nektarios25ma/Solar-tracker/Vertical_Servo_Gear.stl

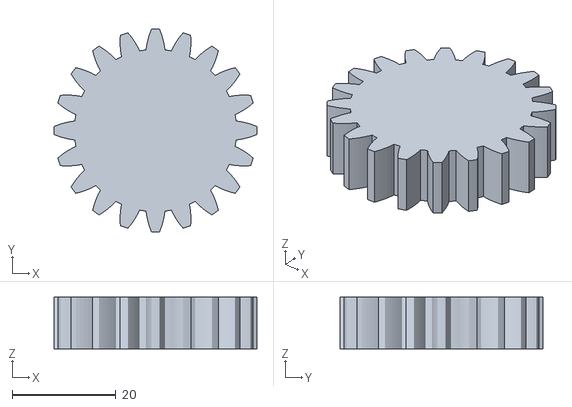
[picture p13: CAD file, 2020-10-01]
Vertical_Servo_Gear.stl
39.2 x 39.2 x 10.0
