nektarios25ma/Solar-tracker/LDR DIVIDER HIGH.stl

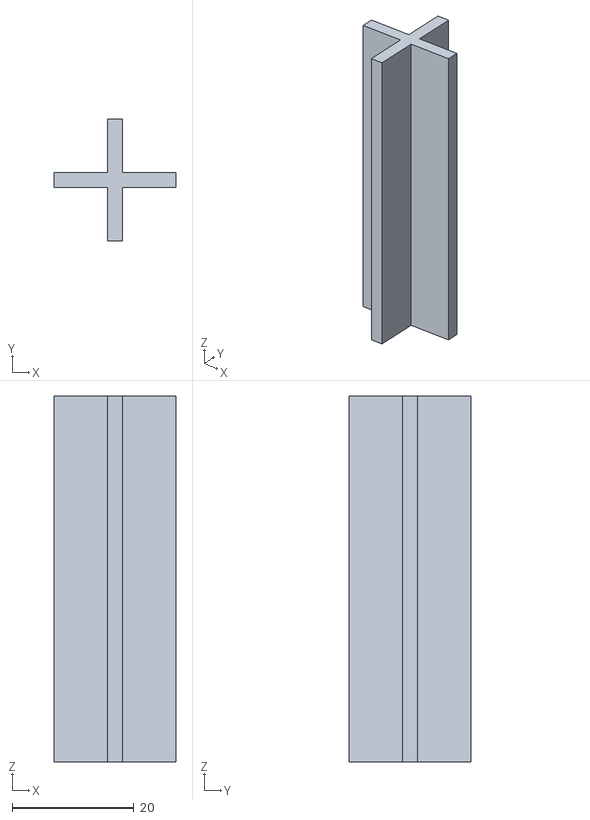
[picture p14: CAD file, 2020-10-01]
LDR DIVIDER HIGH.stl
20.0 x 20.0 x 60.0
