nektarios25ma/Solar-tracker/Panel_Bracket.stl

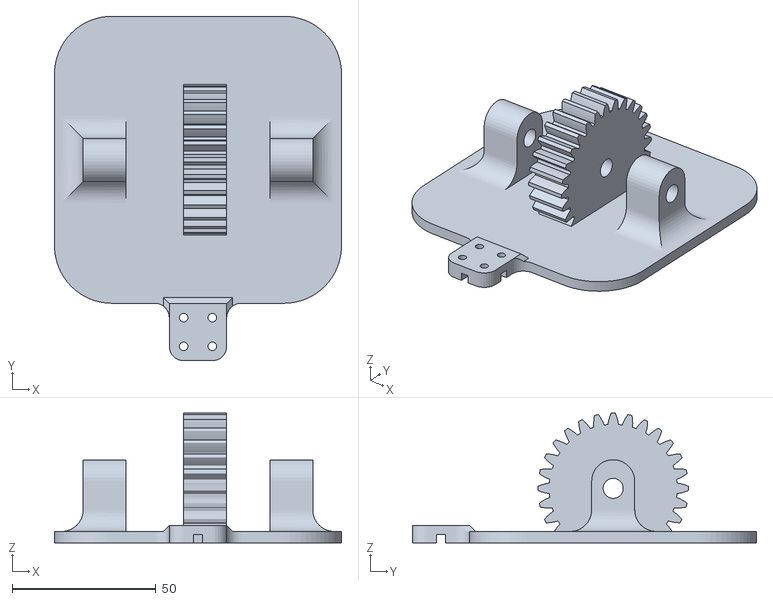
[picture p15: CAD file, 2020-10-01]
Panel_Bracket.stl
100.0 x 120.0 x 45.2
