nektarios25ma/Solar-tracker/Horz_Servo_Gear.stl

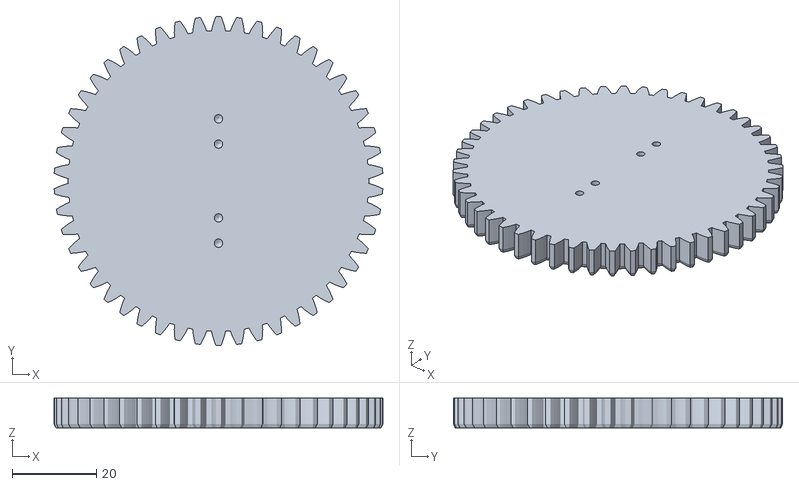
[picture p16: CAD file, 2020-10-01]
Horz_Servo_Gear.stl
77.9 x 78.0 x 7.00
