nektarios25ma/Solar-tracker/Base_Gear_and_Panel_Mount.stl

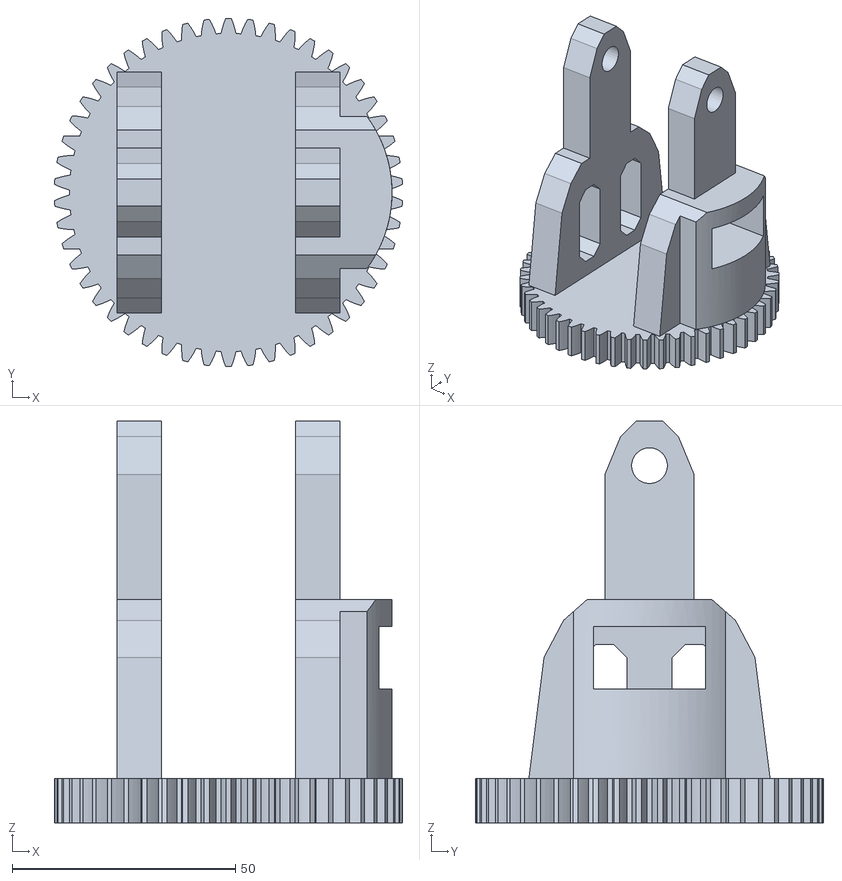
[picture p17: CAD file, 2020-10-01]
Base_Gear_and_Panel_Mount.stl
77.9 x 78.0 x 90.0
