nektarios25ma/Solar-tracker/Tracker_Base.stl

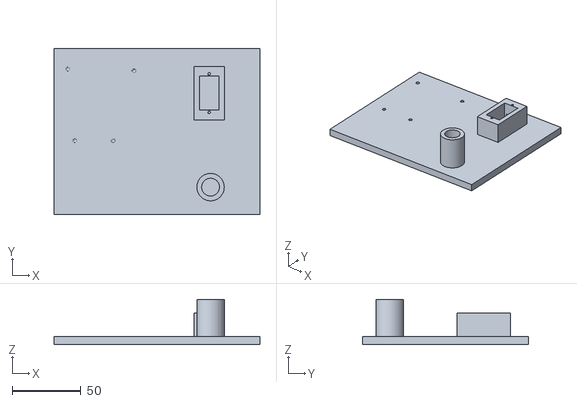
[picture p18: CAD file, 2020-10-01]
Tracker_Base.stl
150.0 x 121.0 x 33.0
