nektarios25ma/Solar-tracker/Base_Gear_Shaft.stl

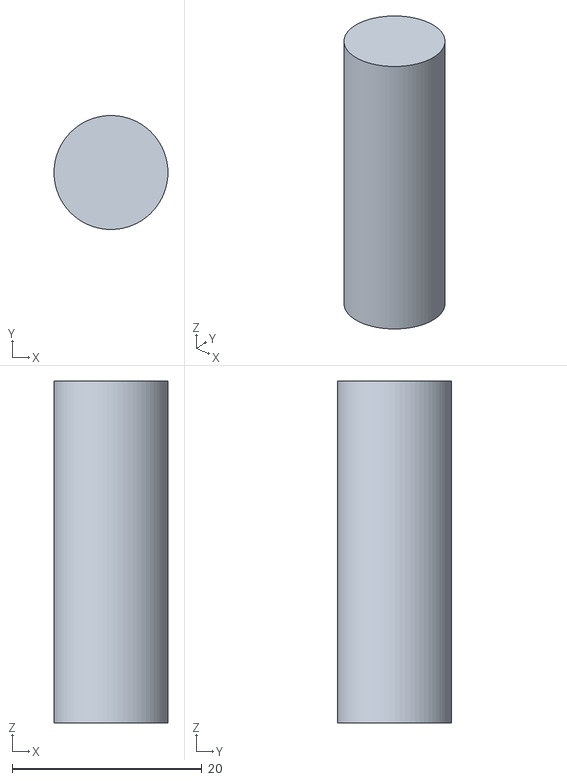
[picture p19: CAD file, 2020-10-01]
Base_Gear_Shaft.stl
12.0 x 12.0 x 36.0
