nektarios25ma/Solar-tracker/construction history.odt

Solar Path Finder

Ιστορικό κατασκεύης

Συντάκτης: Αθηνά Αθανασάκη.

Ξεκινήσαμε κάνοντας εβδομαδιαία μαθήματα ρομποτικής με τον Κ. Κουράκη. Άφου μάθαμε τα βασικά γύρω απο τα κυκλώματα, τον προγραμματισμό και το arduino, προχωρήσαμε σε διάφορες μικρές εργασίες-project για να γίνουμε πιο οικείοι με το arduino.

Μετά από ψάξιμο στο ίντερνετ καταλήξαμε ότι η κατασκευή με την οποία θέλαμε να ασχοληθούμε ήταν ένα solar finder, μιάς και είναι μια συσκευή μέσα στην επικαιρότητα των ημερών αλλά και προσφέρει πολλά περιθώρια για εξέλιξη και πειραματισμό.

Από τις παρακάτω πηγές, πήραμε την αρχική ιδέα για το πως θα έπρεπε να μοιάζει η συσκευή, τη λογική της λειτουργίας της και τον τρόπο προγραμματισμού της.

https://www.instructables.com/id/Arduino-Solar-Tracker/

και τα 3d stl αρχεία από:

https://www.thingiverse.com/thing:53321

(Τα οποία τελικά τα ανασχεδιάσαμε με το online tinkercad)

Έτσι με βάση αυτές, φτιάξαμε μια πρόχειρη κατασκευή χρησιμοποιώντας υλικά απο παιδικά παιχνίδια για να διαπιστώσουμε αν το solar tracker, όντως δούλευε όπως έπρεπε.

Αφού η δοκιμή ολοκληρώθηκε με μερική αποτυχία ,αναγκαστήκαμε να κατανοήσουμε πληρώς το hardware-software και με πολλές διορθώσεις και αλλαγές η 5η δοκιμή μας κατέληξε σε επιτυχία. Ζητήσαμε απο το ΕΚΦΕ Χανίων να μας εκτυπώσει τα 3D κομμάτια που χρειαζόμασταν.

Ξεκινήσαμε γράφοντας ένα απλό πρόγραμμα, ώστε το φωτοβολταϊκό να στρέφεται προς την κατεύθυνση με το περισσότερο φως. Αποφασίσαμε όμως ότι μια ακόμα χρήσιμη εφαρμογή του solar path finder θα ήταν η αποστολή δεδομένων της θέσης του. Με αυτό τον τρόπο μπορούμε να έχουμε καταγραφή των γωνιών που διαγράφει και έτσι, όταν τοποθετείται σε εξωτερικό χώρο, παίρνουμε ξεκάθαρη εικόνα του μονοπατιού του ήλιου σε εκείνη την περιοχή.

Για να το κάνουμε αυτό έπρεπε πρώτα να κατανοήσουμε τον τρόπο με τον οποίο κινείται ο ήλιος και το πως γίνονται αυτές οι μετρήσεις στην πραγματικότητα, ώστε να βρούμε ενα τρόπο για να το κάνουμε μέσω της κατασκευής μας.

Αρχικά προσπαθήσαμε να το κάνουμε με την βοήθεια ενός αισθητήρα επιτάχυνσης-γυροσκοπίου-μαγνητόμετρου, όμως αποδείχθηκε ότι δεν ήταν εύκολο και το ποσοστό σφάλματος ήταν μεγάλο. Με επίπονη βαθμονόμηση-calibration τελικά δούλεψε ικανοποιητικά αλλά ο καθηγητής ,μας προέτρεψε να ασχοληθούμε-εξελίξουμε έναν πιο απλό τρόπο εύρεσης των γωνιών του Ήλιου. Οπότε αποφασίσαμε να αντικαταστήσουμε τα δύο απλά servo με αυτά που στέλνουν πίσω τη θέση στην οποία βρίσκεται το servo σωστά. ( analogfeedback servo).

Μη θέλοντας να διαλύσουμε την πρώτη μας κατασκευή, αποφασίσαμε να ξαναφτιάξουμε ολόκληρο το solar path finder από το μηδέν, κάνοντας ταυτόχρονα και κάποιες διορθώσεις στην δομή του, για να γίνεται πιό σωστή και ομαλή η λειτουργεία του.

Τελικά επανασχεδιάσαμε τα 3d εξαρτήματα 1)για να μπουν τα καινούργια-διαφορετικών διαστάσεων servo στην θέση των παλιών

2)για να μπορεί η κατασκευή να δουλέψει σε εξωτερικό χώρο και να μετράει σωστά τις γωνίες altitude,azimuth του Ήλιου (η πηγή μας και ο αντίστοιχος δημιουργός της https://www.thingiverse.com/thing:53321 - προνόησε μόνο μια κατασκευή επίδειξης -απλά solar tracker- για εσωτερικό χώρο).

Για να σιγουρευτούμε ότι οι τιμές που παίρναμε απο το servo ήταν σωστές, κάναμε κάποιες δοκιμές , βαθμονόμηση των servo(calibration).

Καταλήξαμε στην δημιουργία χαρτών -map, ώστε να γίνει αναλογία των τιμών που έδινε με τις πραγματικές.

Έπειτα, ξαναγράψαμε το πρόγραμμα του solar path finder κάνοντας τις απαραίτητες αλλαγές και το δοκιμάσαμε αρκετές φορές, ώστε να λύσουμε τυχόν σφάλματα που παρουσίαζε στην λειτουργία του.

Με το δικό μας λογισμικό μπορεί να γινεί live αναπαραγωγή των δεδομένων που συλλέγει το solar path finder και έτσι οποιοσδήποτε και απο οπουδήποτε να έχει πρόσβαση σε αυτές τις πληροφοριές τις οποίες μπορεί να χρησιμοποιήσει για τις δικές του εργασίες.

ΓΕΛ – ΕΠΑΛ ΚΙΣΑΜΟΥ(ΣΥΝΕΡΓΑΣΙΑ)

Οι μαθητές :

ΑΘΗΝΑ ΑΘΑΝΑΣΑΚΗ

ΣΠΥΡΙΔΩΝ ΕΙΡΗΝΑΚΗΣ

ΣΤΕΛΛΑ ΑΜΠΟΥΧΑΝΗ

Ο επιβλέπων καθηγητής:

ΚΟΥΡΑΚΗΣ ΝΕΚΤΑΡΙΟΣ

ΣΥΝΤΑΚΤΗΣ:ΑΘΗΝΑ ΑΘΑΝΑΣΑΚΗ
